nico-07-26/Interruptor-Crepuscular-con-el-LM358/INTERRUPTOR CREPUSCLUAR/LINK TINKERCAD.txt

https://www.tinkercad.com/things/ducnxxVqXz4-interruptor-crepuscular/editel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
