nico-07-26/Interruptor-Crepuscular-con-el-LM358/(list of files, drawings)

Other design files:
INTERRUPTOR CREPUSCLUAR/INTERRUPTOR-CREPUSCULAR.pdsprj
